yak5150/paddle-shift/CAD/pneumatics/tippmann-12oz-co2-paintball-tank-adapter-to-cga320-1.snapshot.4/Screenshot 2023-11-20 222517.png

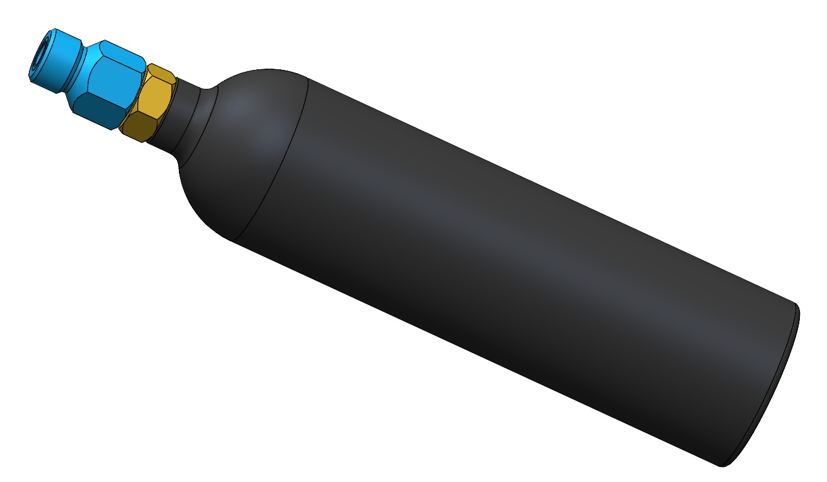
CAD/pneumatics/tippmann-12oz-co2-paintball-tank-adapter-to-cga320-1.snapshot.4/Screenshot 2023-11-20 222517.png
