yak5150/paddle-shift/classwork/SD2_Team17_advisor approval.png

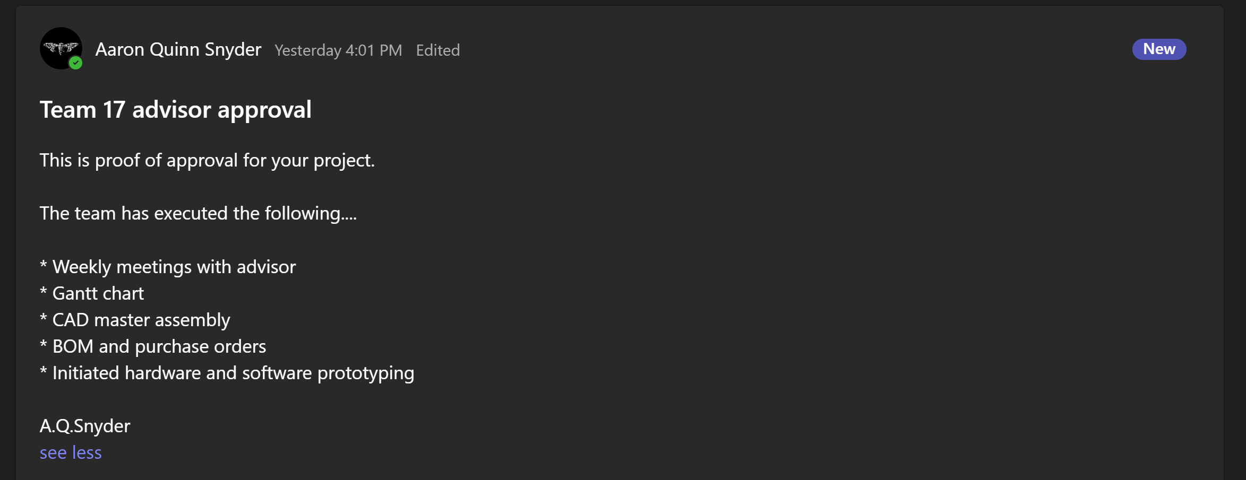
classwork/SD2_Team17_advisor approval.png
