yak5150/paddle-shift/budget/Order 2024-02-01.xlsx

Sheet: Master
SD II - 24SP - Team 17 |  | Order Date: [insert] |  |  |  | Est. Total | $224.59
Category | Description | Part No. | Link | Qty | Price | Est. Shipping | Total Cost | Notes | Team Signed | Advisor Signed | Order Date | Delivered Date | Mechanical
Mechanical | Arbitary 6061 Aluminum Billet |  | https://www.mcmaster.com/8975K253-8975K311/ | 1 | $37.56 |  | $37.56 |  |  |  |  |  | Electrical
Pneumatic | 4 way 3 postion solenoid valve | 4V130E-1/8 | https://www.stcvalve.com/Solenoid-Valve/4V130C-E-P-1-8.htm | 1 | $101.79 |  | $101.79 |  | yes | yes |  |  | Pneumatic
Pneumatic | CO2 tank |  | https://www.discountpaintball.com/tippmann-12oz-aluminum-co2-tank-for-paintball.html | 1 | $17.90 | $10.00 | $27.90 |  | yes | yes
Pneumatic | N2 tank | 48ci/3000psi | https://www.amazon.com/HK-Army-Aluminum-Compressed-Paintball/dp/B07MR6QCSR?th=1 | 1 | $49.95 | $0.00 | $49.95 | 48 ci 3000 psi, black | yes | yes
Pneumatic | fittings |  |  |  |  |  | $0.00
Electrical | Arduino |  |  | 1 | $0.00 | $0.00 | $0.00 | Free | yes | yes
Pneumatic | Air cylinder |  |  |  |  |  | $0.00
Pneumatic | Air regulator |  |  |  |  |  | $0.00
Pneumatic | Air lines |  |  |  |  |  | $0.00
Mechanical | Springs |  |  |  |  |  | $0.00
Mechanical | Bushings |  |  |  |  |  | $0.00
Mechanical | Hardware |  |  |  |  |  | $0.00
Electrical | Sensors |  |  |  |  |  | $0.00
Electrical | 12 VDC 4 Channel Relay Module (https://www.amazon.com/dp/B00LW2GM84?asc_source=01HFY6QA7Q8N1TT2Z879WGSZ46&tag=snx79-20) |  | Amazon.com: HiLetgo 12V 4 Channel Relay Module with OPTO-Isolated Support High and Low Level Trigger : Industrial & Scientific (https://www.amazon.com/dp/B00LW2GM84?asc_source=01HFY6QA7Q8N1TT2Z879WGSZ46&tag=snx79-20) | 1 | $7.39 |  | $7.39 | Lets wait to see which types of sensors we are going to use to determine if 4 relay modules is enough

Sheet: Order 2024-02-01
SD II - 24SP - Team 17 |  | Order Date: 2024-02-01 |  |  |  | Est. Total | $179.64
Category | Description | Part No. | Link | Qty | Price | Est. Shipping | Total Cost | Notes | Team Signed | Advisor Signed | Order Date | Delivered Date | Mechanical
Pneumatic | 4 way 3 postion solenoid valve | 4V130E-1/8 | https://www.stcvalve.com/Solenoid-Valve/4V130C-E-P-1-8.htm | 1 | $101.79 |  | $101.79 |  | yes | yes |  |  | Electrical
Pneumatic | CO2 tank | 100-640-01010 | https://www.discountpaintball.com/tippmann-12oz-aluminum-co2-tank-for-paintball.html | 1 | $17.90 | $10.00 | $27.90 |  | yes | yes |  |  | Pneumatic
Pneumatic | N2 tank | 48ci/3000psi | https://www.amazon.com/HK-Army-Aluminum-Compressed-Paintball/dp/B07MR6QCSR?th=1 | 1 | $49.95 | $0.00 | $49.95 | 48 ci 3000 psi, black | yes | yes
