yak5150/paddle-shift/budget/Order 2024-02-16 (AutoDir).xlsx

SD II - 24SP - Team 17 |  | Order Date: 2024-02-16 |  |  |  | Est. Total | $193.75
Category | Description | Part No. | Link | Qty | Price | Est. Shipping | Total Cost | Notes | Team Signed | Advisor Signed | Order Date | Delivered Date | Mechanical
Pneumatic | flow control valve | FVS516-18N | https://www.automationdirect.com/adc/shopping/catalog/pneumatic_components/special_purpose_pneumatic_fittings/flow_control_valves_-_speed_controllers/fvs516-18n | 2 | $21.00 |  | $42.00 | Automation Direct |  |  | 2024-02-16
Pneumatic | air regulator | PRU516 | https://www.automationdirect.com/adc/shopping/catalog/pneumatic_components/special_purpose_pneumatic_fittings/pressure_regulators_-z-_gauges_-z-_indicators/pr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 | 1 | $26.50 |  | $26.50 | Automation Direct |  |  | 2024-02-16
Pneumatic | on-off valve | HVU516-2 | https://www.automationdirect.com/adc/shopping/catalog/pneumatic_components/special_purpose_pneumatic_fittings/hand_valves/hvu516-2 | 1 | $15.50 |  | $15.50 | Automation Direct |  |  | 2024-02-16
Pneumatic | cylinder | A17010DP | https://www.automationdirect.com/adc/shopping/catalog/pneumatic_components/pneumatic_air_cylinders/non-repairable/a17010dp | 1 | $35.00 |  | $35.00 | Automation Direct |  |  | 2024-02-16
Pneumatic | exhaust silencer/filter | SBF-18N | https://www.automationdirect.com/adc/shopping/catalog/pneumatic_components/exhaust_silencers/bronze_exhaust_silencers/sbf-18n | 1 | $3.25 |  | $3.25 | Automation Direct |  |  | 2024-02-16
Pneumatic | air pressure gauge | PGU516 | https://www.automationdirect.com/adc/shopping/catalog/pneumatic_components/special_purpose_pneumatic_fittings/pressure_regulators_-z-_gauges_-z-_indicators/pg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 | 1 | $23.50 |  | $23.50 | Automation Direct |  |  | 2024-02-16
Pneumatic | 5/16" (8mm) air hose - 100ft roll | N8MRED100 | https://www.automationdirect.com/adc/shopping/catalog/pneumatic_components/flexible_pneumatic_tubing_-a-_hoses/straight_flexible_tubing/n8mred100 | 1 | $40.00 |  | $40.00 | Automation Direct |  |  | 2024-02-16
Pneumatic | male 1/8 NPT push to connect fitting | MS516-18N | https://www.automationdirect.com/adc/shopping/catalog/pneumatic_components/push-to-connect_pneumatic_fittings/male_straight_(hex_body)/ms516-18n | 1 | $8.00 |  | $8.00 | Automation Direct |  |  | 2024-02-16
