yak5150/paddle-shift/budget/Order 2024-03-11.xlsx

SD II - 24SP - Team 17 |  | Order Date: 2024-03-11 |  |  |  | Est. Total | $79.84
Category | Description | Part No. | Link | Qty | Price | Est. Shipping | Total Cost | Notes | Team Signed | Advisor Signed | Order Date | Delivered Date | Mechanical
Mechanical | Tight-Tolerance Low-Carbon Steel Rod | 6103N8 | https://www.mcmaster.com/6103N8-6103N81/ | 1 | $8.67 |  | $8.67 | Replacement part for 6061K31 | yes | yes | 2024-03-06
Mechanical | Single 4-Slot Rail, Silver, 1.5" High x 1.5" Wide, Hollow | 47065T102 | https://www.mcmaster.com/catalog/130/2230/47065T102 | 1 | $60.49 |  | $60.49 |  | yes | yes | 2024-03-06
Mechanical | End-Feed Single Nut with Button Head 5/16"-18 Thread | 47065T215 | https://www.mcmaster.com/47065T215/ | 3 | $3.56 |  | $10.68 |  | yes | yes | 2024-03-06
