yak5150/paddle-shift/budget/Order 2024-03-27.xlsx

SD II - 24SP - Team 17 |  | Order Date: [2024-03-27] |  |  |  | Est. Total | $70.99
Category | Description | Part No. | Link | Qty | Price | Est. Shipping | Total Cost | Notes | Team Signed | Advisor Signed | Order Date | Delivered Date | Mechanical
Pneumatic | male 1/8 NPT push to connect fitting | MS516-18N | https://www.automationdirect.com/adc/shopping/catalog/pneumatic_components/push-to-connect_pneumatic_fittings/male_straight_(hex_body)/ms516-18n | 1 | $8.00 |  | $8.00 |  | yes | yes | 2024-03-27
Pneumatic | Paintball Co2 Regulator Pressure Regulator for Airsoft HPA Tank Mini Sef Super Fast Refresh, Input 1500psi Output 0 to 130psi |  | https://www.amazon.com/AUGREX-Paintball-Regulator-Pressure-Airsoft/dp/B0BYN8LMY6 | 1 | $62.99 |  | $62.99 |  | yes |  | 2024-03-27
