yak5150/paddle-shift/budget/Team17_Parts24_Sp24.xlsx

Sheet: Master
SD II - 24SP - Team 17 |  | Order Date: [insert] |  |  |  | Est. Total | $362.58
Category | Description | Part No. | Link | Qty | Price | Est. Shipping | Total Cost | Notes | Team Signed | Advisor Signed | Order Date | Delivered Date | Mechanical
Pneumatic | 4 way 3 postion solenoid valve | 4V130E-1/8-12VDC | https://www.stcvalve.com/Solenoid-Valve/4V130C-E-P-1-8.htm | 1 | $101.79 |  | $101.79 | Select 12VDC when filling out order sheet. | yes | yes | 2024-02-01 | 2024-02-09 | Electrical
Pneumatic | CO2 tank | 12T-R | https://www.amazon.com/Tippmann-12T-R-12-Ounce-Co2-Tank/dp/B002DPLGH6 | 1 | $29.95 |  | $29.95 |  | yes | yes | 2024-02-01 | 2024-02-12 | Pneumatic
Pneumatic | N2 tank | 48ci/3000psi | https://www.amazon.com/HK-Army-Aluminum-Compressed-Paintball/dp/B07MR6QCSR?th=1 | 1 | $49.95 | $0.00 | $49.95 | 48 ci 3000 psi, black | yes | yes | 2024-02-01 | 2024-02-07
Mechanical | Springs 3x pack 1.75L x 0.75OD | 9657K96 | https://www.mcmaster.com/9657K96/ | 1 | $14.38 |  | $14.38 |  | yes |  | 2024-02-12
Mechanical | linear motion shaft 12"L x 0.25OD | 6061K31 | https://www.mcmaster.com/6061K31/ | 1 | $7.50 |  | $7.50 |  | yes |  | 2024-02-12
Mechanical | oil embedded flange bushings | 6338K413 | https://www.mcmaster.com/6338K413/ | 2 | $2.00 |  | $4.00 |  | yes |  | 2024-02-12
Electrical | Pressure Sensor |  | M12 X 1.5 Coolant Pressure & Temperature Combo 100 PSI / 500*F PN: 899 (lowdoller-motorsports.com) (https://lowdoller-motorsports.com/products/m12-x-1-5-coolant-pressure-temperature-combo-100-psi-500-f) | 1 | $90.00 |  | $90.00 |  |  |  | 2024-02-12 | 2024-02-15
Electrical | 12 VDC 4 Channel Relay Module (https://www.amazon.com/dp/B00LW2GM84?asc_source=01HFY6QA7Q8N1TT2Z879WGSZ46&tag=snx79-20) |  | Amazon.com: HiLetgo 12V 4 Channel Relay Module with OPTO-Isolated Support High and Low Level Trigger : Industrial & Scientific (https://www.amazon.com/dp/B00LW2GM84?asc_source=01HFY6QA7Q8N1TT2Z879WGSZ46&tag=snx79-20) | 1 | $7.39 |  | $7.39 |  | yes |  | 2024-02-12
Pneumatic | CO2 Refilling adaptor |  | Amazon.com : VaVoger Paintball CO2 Tank Refill Station CO2 Cartridges Fill Adapter Strage Stainless Steel Connector Hose for 12oz, 16oz, 20oz, CO2 Tanks : Sports & Outdoors (https://www.amazon.com/dp/B08MLG7S71?s=sporting-goods&sp_csd=d2lkZ2V0TmFtZT1zcF9kZXRhaWxfdGhlbWF0aWM) | 1 | $38.99 | $0.00 |  |  | yes |  | 2024-02-12
Pneumatic | CO2 Scale |  | Amazon.com : HEETA Fish Scale with Backlit LCD Display, Up to 110lb/50kg Digital Portable Hanging Fish Weight Scale with Hook & Measuring Tape for Home, Farm, Outdoor, Hunting, Fishing, 2 AAA Batteries Included : Sports & Outdoors (https://www.amazon.com/HEETA-Portable-Measuring-Batteries-Included/dp/B07SSYVWTJ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) | 1 | $9.99 | $0.00 | $9.99 |  | yes |  | 2024-02-12
Electrical | 12 V to 5 V Buck Converter |  | https://www.amazon.com/Converter-DROK-Regulator-Inverter-Transformer/dp/B01NALDSJ0 | 1 | $9.99 | $0.00 | $9.99 | To power sensors | yes |  | 2024-02-12
Electrical | Arduino |  |  | 1 | $0.00 | $0.00 | $0.00 | Free | yes | yes |  | 2024-01-31
Pneumatic | Nitrogen Tank Refill Fitting
Electrical | MAX31865 Temperature Sensor Amplifier |  | https://www.digikey.com/en/products/detail/adafruit-industries-llc/3328/6562952 | 2 | $15.00 |  | $30.00 | To convert temperature sensor into readable values for Arduino | yes | yes | 2024-02-19
Pneumatic | flow control valve | FVS516-18N | https://www.automationdirect.com/adc/shopping/catalog/pneumatic_components/special_purpose_pneumatic_fittings/flow_control_valves_-_speed_controllers/fvs516-18n | 2 | $0.00 |  | $0.00 | Automation Direct - Free | yes | yes | 2024-02-16
Pneumatic | air regulator | PRU516 | https://www.automationdirect.com/adc/shopping/catalog/pneumatic_components/special_purpose_pneumatic_fittings/pressure_regulators_-z-_gauges_-z-_indicators/pr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 | 1 | $0.00 |  | $0.00 | Automation Direct - Free | yes | yes | 2024-02-16
Pneumatic | on-off valve | HVU516-2 | https://www.automationdirect.com/adc/shopping/catalog/pneumatic_components/special_purpose_pneumatic_fittings/hand_valves/hvu516-2 | 1 | $0.00 |  | $0.00 | Automation Direct - Free | yes | yes | 2024-02-16
Pneumatic | cylinder | A17010DP | https://www.automationdirect.com/adc/shopping/catalog/pneumatic_components/pneumatic_air_cylinders/non-repairable/a17010dp | 1 | $0.00 |  | $0.00 | Automation Direct - Free | yes | yes | 2024-02-16
Pneumatic | exhaust silencer/filter | SBF-18N | https://www.automationdirect.com/adc/shopping/catalog/pneumatic_components/exhaust_silencers/bronze_exhaust_silencers/sbf-18n | 1 | $0.00 |  | $0.00 | Automation Direct - Free | yes | yes | 2024-02-16
Pneumatic | air pressure gauge | PGU516 | https://www.automationdirect.com/adc/shopping/catalog/pneumatic_components/special_purpose_pneumatic_fittings/pressure_regulators_-z-_gauges_-z-_indicators/pg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 | 1 | $0.00 |  | $0.00 | Automation Direct - Free | yes | yes | 2024-02-16
Pneumatic | 5/16" (8mm) air hose - 100ft roll | N8MRED100 | https://www.automationdirect.com/adc/shopping/catalog/pneumatic_components/flexible_pneumatic_tubing_-a-_hoses/straight_flexible_tubing/n8mred100 | 1 | $0.00 |  | $0.00 | Automation Direct - Free | yes | yes | 2024-02-16
Pneumatic | male 1/8 NPT push to connect fitting | MS516-18N | https://www.automationdirect.com/adc/shopping/catalog/pneumatic_components/push-to-connect_pneumatic_fittings/male_straight_(hex_body)/ms516-18n | 1 | $0.00 |  | $0.00 | Automation Direct - Free | yes | yes | 2024-02-16
Mechanical | 1.5 X 1.5 60"Long Lite, Clear Anodise 8020 |  | 8020, 1515, 15 Series 1.5 Inch x 1.5 Inch T-Slotted Aluminum Extrusion DIY Extruded Linear Slot Bar Rail 80/20 (Ultra Light Smooth, Clear Anodize, 60" Long): Shelving Hardware: Amazon.com: Industrial & Scientific (https://www.amazon.com/80-20-1515-ULS-T-Slotted-Extrusion/dp/B07TGKRD2W) | 1 | $41.19
z | 8020 harware M5 x0.8 |  | Amazon.com: Black Screws Nuts Kit for 2020 2028 Series Conrner Bracket Connector, 40Pcs M5 x 10mm, M5 x 8mm Hex Socket Button Head Cap Screws Bolts, 40PCS M5 Slide in T Nut, M5 Drop in T Nut, 40PCS M5 Washers : Industrial & Scientific (https://www.amazon.com/Screws-Conrner-Bracket-Connector-Washers/dp/B08VGSNT2S?s=hi) | 1 | $13.88
Mechanical | M5 x 0.8 mm screw (25 mm length) | 92095A216 | Button Head Hex Drive Screw, Passivated 18-8 Stainless Steel, M5 x 0.80 mm Thread, 25mm Long | McMaster-Carr (https://www.mcmaster.com/92095A216/) | 1 | $7.64 |  | $7.64

Sheet: Order 2024-02-26
Mechanical | 1.5 X 1.5 60"Long Lite, Clear Anodise 8020 |  | 8020, 1515, 15 Series 1.5 Inch x 1.5 Inch T-Slotted Aluminum Extrusion DIY Extruded Linear Slot Bar Rail 80/20 (Ultra Light Smooth, Clear Anodize, 60" Long): Shelving Hardware: Amazon.com: Industrial & Scientific (https://www.amazon.com/80-20-1515-ULS-T-Slotted-Extrusion/dp/B07TGKRD2W) | 1 | $41.19
Mechanical | 8020 harware M5 x0.8 |  | Amazon.com: Black Screws Nuts Kit for 2020 2028 Series Conrner Bracket Connector, 40Pcs M5 x 10mm, M5 x 8mm Hex Socket Button Head Cap Screws Bolts, 40PCS M5 Slide in T Nut, M5 Drop in T Nut, 40PCS M5 Washers : Industrial & Scientific (https://www.amazon.com/Screws-Conrner-Bracket-Connector-Washers/dp/B08VGSNT2S?s=hi) | 1 | $13.88
Mechanical | M5 x 0.8 mm screw (25 mm length) | 92095A216 | Button Head Hex Drive Screw, Passivated 18-8 Stainless Steel, M5 x 0.80 mm Thread, 25mm Long | McMaster-Carr (https://www.mcmaster.com/92095A216/) | 1 | $7.64 | $29.95

Sheet: Order 2024-02-01
SD II - 24SP - Team 17 |  | Order Date: [2024-02-01] |  |  |  | Est. Total | $181.69
Category | Description | Part No. | Link | Qty | Price | Est. Shipping | Total Cost | Notes | Team Signed | Advisor Signed | Order Date | Delivered Date | Mechanical
Pneumatic | 4 way 3 postion solenoid valve | 4V130E-1/8-12VDC | https://www.stcvalve.com/Solenoid-Valve/4V130C-E-P-1-8.htm | 1 | $101.79 |  | $101.79 | Select 12VDC when filling out order sheet. | yes | yes | 2024-02-01 |  | Electrical
Pneumatic | CO2 tank | 12T-R | https://www.amazon.com/Tippmann-12T-R-12-Ounce-Co2-Tank/dp/B002DPLGH6 | 1 | $29.95 |  | $29.95 |  | yes | yes | 2024-02-01 |  | Pneumatic
Pneumatic | N2 tank | 48ci/3000psi | https://www.amazon.com/HK-Army-Aluminum-Compressed-Paintball/dp/B07MR6QCSR?th=1 | 1 | $49.95 | $0.00 | $49.95 | 48 ci 3000 psi, black | yes | yes | 2024-02-01

Sheet: Order 2024-02-12
SD II - 24SP - Team 17 |  | Order Date: [2024-02-12] |  |  |  | Est. Total | $272.24
Category | Description | Part No. | Link | Qty | Price | Est. Shipping | Total Cost | Notes | Team Signed | Advisor Signed | Order Date | Delivered Date
Electrical | Pressure Sensor |  | M12 X 1.5 Coolant Pressure & Temperature Combo 100 PSI / 500*F PN: 899 (lowdoller-motorsports.com) (https://lowdoller-motorsports.com/products/m12-x-1-5-coolant-pressure-temperature-combo-100-psi-500-f) | 2 | $90.00 |  | $180.00 |  |  |  | 2024-02-12
Electrical | 12 VDC 4 Channel Relay Module (https://www.amazon.com/dp/B00LW2GM84?asc_source=01HFY6QA7Q8N1TT2Z879WGSZ46&tag=snx79-20) |  | Amazon.com: HiLetgo 12V 4 Channel Relay Module with OPTO-Isolated Support High and Low Level Trigger : Industrial & Scientific (https://www.amazon.com/dp/B00LW2GM84?asc_source=01HFY6QA7Q8N1TT2Z879WGSZ46&tag=snx79-20) | 1 | $7.39 |  | $7.39 |  |  |  | 2024-02-12
Pneumatic | CO2 Refilling adaptor |  | Amazon.com : VaVoger Paintball CO2 Tank Refill Station CO2 Cartridges Fill Adapter Strage Stainless Steel Connector Hose for 12oz, 16oz, 20oz, CO2 Tanks : Sports & Outdoors (https://www.amazon.com/dp/B08MLG7S71?s=sporting-goods&sp_csd=d2lkZ2V0TmFtZT1zcF9kZXRhaWxfdGhlbWF0aWM) | 1 | $38.99 | $0.00 | $38.99 |  |  |  | 2024-02-12
Pneumatic | CO2 Scale |  | Amazon.com : HEETA Fish Scale with Backlit LCD Display, Up to 110lb/50kg Digital Portable Hanging Fish Weight Scale with Hook & Measuring Tape for Home, Farm, Outdoor, Hunting, Fishing, 2 AAA Batteries Included : Sports & Outdoors (https://www.amazon.com/HEETA-Portable-Measuring-Batteries-Included/dp/B07SSYVWTJ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) | 1 | $9.99 | $0.00 | $9.99 |  |  |  | 2024-02-12
Electrical | 12 V to 5 V Buck Converter |  | https://www.amazon.com/Converter-DROK-Regulator-Inverter-Transformer/dp/B01NALDSJ0 | 1 | $9.99 | $0.00 | $9.99 | To power sensors |  |  | 2024-02-12
Mechanical | Springs 3x pack 1.75L x 0.75OD | 9657K96 | https://www.mcmaster.com/9657K96/ | 1 | $14.38 |  | $14.38 |  | yes |  | 2024-02-12
Mechanical | linear motion shaft 12"L x 0.25OD | 6061K31 | https://www.mcmaster.com/6061K31/ | 1 | $7.50 |  | $7.50 |  | yes |  | 2024-02-12
Mechanical | oil embedded flange bushings | 6338K413 | https://www.mcmaster.com/6338K413/ | 2 | $2.00 |  | $4.00 |  | yes |  | 2024-02-12

Sheet: Order 2024-02-16 (AutoDir)
SD II - 24SP - Team 17 |  | Order Date: 2024-02-16 |  |  |  | Est. Total | $193.75
Category | Description | Part No. | Link | Qty | Price | Est. Shipping | Total Cost | Notes | Team Signed | Advisor Signed | Order Date | Delivered Date | Mechanical
Pneumatic | flow control valve | FVS516-18N | https://www.automationdirect.com/adc/shopping/catalog/pneumatic_components/special_purpose_pneumatic_fittings/flow_control_valves_-_speed_controllers/fvs516-18n | 2 | $21.00 |  | $42.00 | Automation Direct |  |  | 2024-02-16
Pneumatic | air regulator | PRU516 | https://www.automationdirect.com/adc/shopping/catalog/pneumatic_components/special_purpose_pneumatic_fittings/pressure_regulators_-z-_gauges_-z-_indicators/pr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 | 1 | $26.50 |  | $26.50 | Automation Direct |  |  | 2024-02-16
Pneumatic | on-off valve | HVU516-2 | https://www.automationdirect.com/adc/shopping/catalog/pneumatic_components/special_purpose_pneumatic_fittings/hand_valves/hvu516-2 | 1 | $15.50 |  | $15.50 | Automation Direct |  |  | 2024-02-16
Pneumatic | cylinder | A17010DP | https://www.automationdirect.com/adc/shopping/catalog/pneumatic_components/pneumatic_air_cylinders/non-repairable/a17010dp | 1 | $35.00 |  | $35.00 | Automation Direct |  |  | 2024-02-16
Pneumatic | exhaust silencer/filter | SBF-18N | https://www.automationdirect.com/adc/shopping/catalog/pneumatic_components/exhaust_silencers/bronze_exhaust_silencers/sbf-18n | 1 | $3.25 |  | $3.25 | Automation Direct |  |  | 2024-02-16
Pneumatic | air pressure gauge | PGU516 | https://www.automationdirect.com/adc/shopping/catalog/pneumatic_components/special_purpose_pneumatic_fittings/pressure_regulators_-z-_gauges_-z-_indicators/pg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 | 1 | $23.50 |  | $23.50 | Automation Direct |  |  | 2024-02-16
Pneumatic | 5/16" (8mm) air hose - 100ft roll | N8MRED100 | https://www.automationdirect.com/adc/shopping/catalog/pneumatic_components/flexible_pneumatic_tubing_-a-_hoses/straight_flexible_tubing/n8mred100 | 1 | $40.00 |  | $40.00 | Automation Direct |  |  | 2024-02-16
Pneumatic | male 1/8 NPT push to connect fitting | MS516-18N | https://www.automationdirect.com/adc/shopping/catalog/pneumatic_components/push-to-connect_pneumatic_fittings/male_straight_(hex_body)/ms516-18n | 1 | $8.00 |  | $8.00 | Automation Direct |  |  | 2024-02-16
