yak5150/paddle-shift/classwork/Template_Budget_Fa23.xlsx

Team XXX
 | Item | Supplier | Part Number | URL (if appropriate) | Unit Cost | Number | Est Shipping | Total Cost
SUPPLIES | widget | Acme supplies | XX00123 | www.roadrunner.com | $1.98 | 3 |  | $5.94
 |  |  |  |  |  | FINAL COST |  | $0.00
