yak5150/paddle-shift/CAD/test_bench_assy.SLDASM

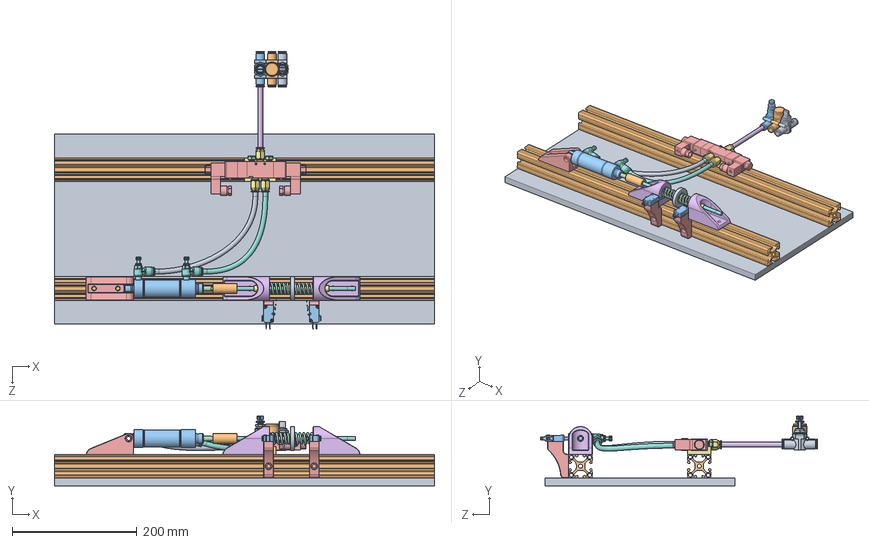
[picture p19: CAD file, 2024-04-10]
CAD/test_bench_assy.SLDASM
609.6 x 112.1 x 444.6 mm
bench
47065T144_T-Slotted Framing x 2
a17010dp_01
a17010dp_02
cylinder support
shaft support x 2
6338K413_Oil-Embedded Flanged Sleeve Bearing x 2
6061K31_Linear Motion Shaft x 2
spring pusher
coupler
7779K23_Miniature Snap-Acting Switch x 2
9657K96_Compression Spring x 2
switch mount x 2
90850A100_Grade 9 Steel Washer x 2
ms516-18n x 3
fvs516-18n x 2
hvu516-2
pgu516
pru516
sbf-18n x 2
4V130(CEP)-06-D
line-reg-sol
solenoid mount
line-cyl-retract
line-cyl-extend
