yak5150/paddle-shift/CAD/pneumatics/tippmann-12oz-co2-paintball-tank-adapter-to-cga320-1.snapshot.4/Bottle w adapter ASSY.SLDASM

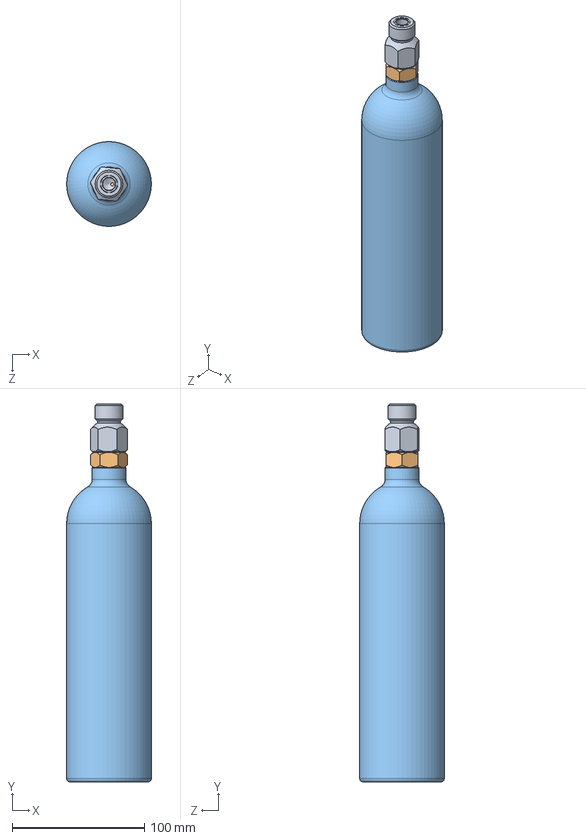
[picture p20: CAD file, 2024-04-10]
CAD/pneumatics/tippmann-12oz-co2-paintball-tank-adapter-to-cga320-1.snapshot.4/Bottle w adapter ASSY.SLDASM
64.1 x 286.0 x 64.0 mm
Bottle
Bottle Top
Paintball x CGA320 Adapter
