yak5150/paddle-shift/CAD/actuator_mech/actuator_mech_assy.SLDASM

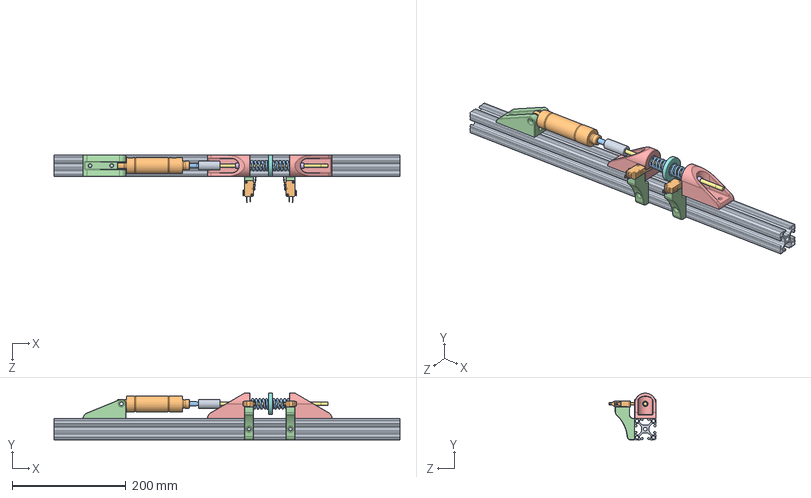
[picture p21: CAD file, 2024-04-10]
CAD/actuator_mech/actuator_mech_assy.SLDASM
609.6 x 82.5 x 83.4 mm
47065T144_T-Slotted Framing
a17010dp_01
a17010dp_02
cylinder support
shaft support x 2
6338K413_Oil-Embedded Flanged Sleeve Bearing x 2
6061K31_Linear Motion Shaft x 2
spring pusher
coupler
7779K23_Miniature Snap-Acting Switch x 2
9657K96_Compression Spring x 2
switch mount x 2
90850A100_Grade 9 Steel Washer x 2
