yak5150/paddle-shift/CAD/pneumatics/pneumatics_assy.SLDASM

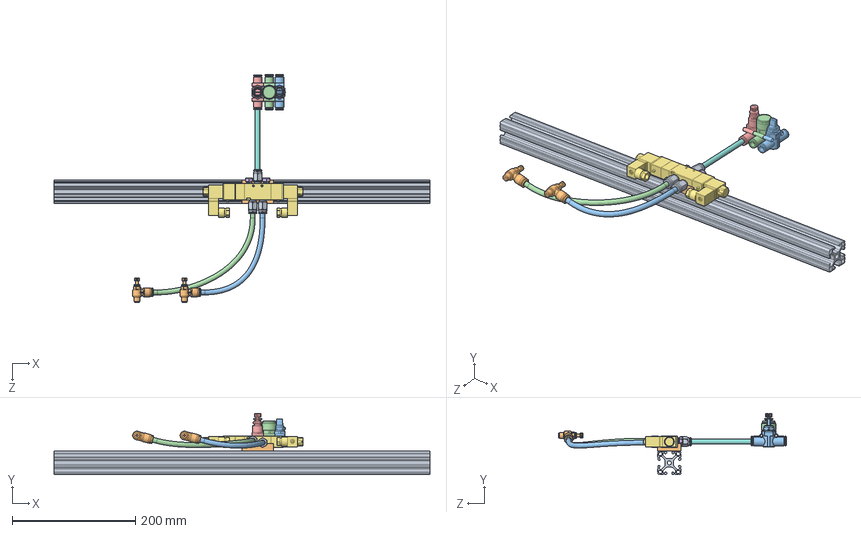
[picture p22: CAD file, 2024-04-10]
CAD/pneumatics/pneumatics_assy.SLDASM
609.6 x 99.4 x 369.2 mm
ms516-18n x 3
fvs516-18n x 2
hvu516-2
pgu516
pru516
sbf-18n x 2
4V130(CEP)-06-D
line-reg-sol
47065T144_T-Slotted Framing
solenoid mount
line-cyl-retract
line-cyl-extend
