yak5150/paddle-shift/CAD/actuator_mech/print 2024-02-12/shaft support.STL

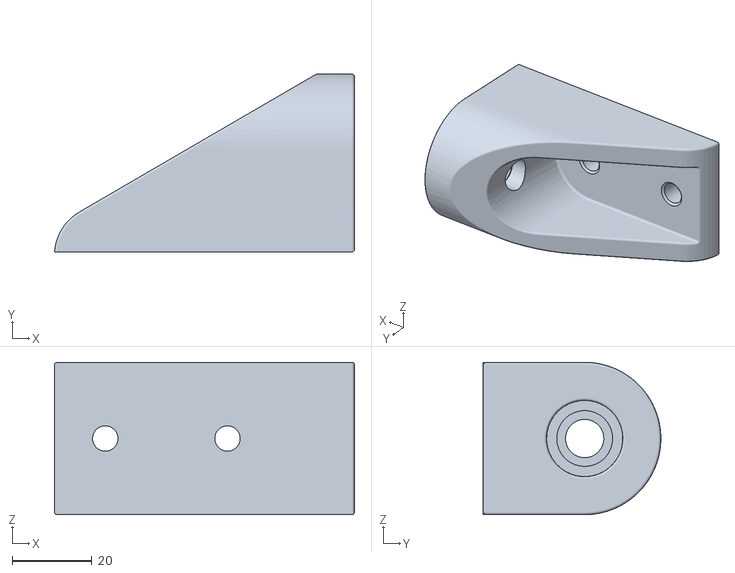
[picture p23: CAD file, 2024-04-10]
CAD/actuator_mech/print 2024-02-12/shaft support.STL
75.0 x 44.4 x 38.1
