yak5150/paddle-shift/CAD/actuator_mech/print 2024-02-21/switch mount (right).STL

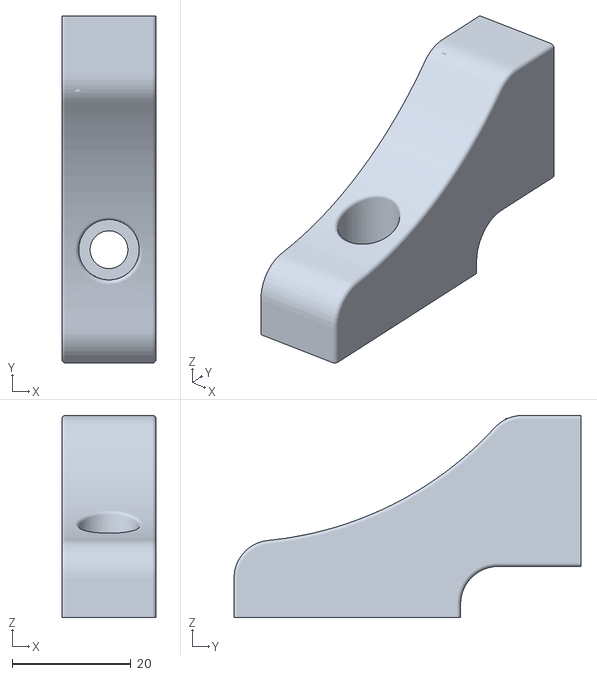
[picture p24: CAD file, 2024-04-10]
CAD/actuator_mech/print 2024-02-21/switch mount (right).STL
15.9 x 58.4 x 34.0
