yak5150/paddle-shift/CAD/pneumatics/pru516.SLDPRT

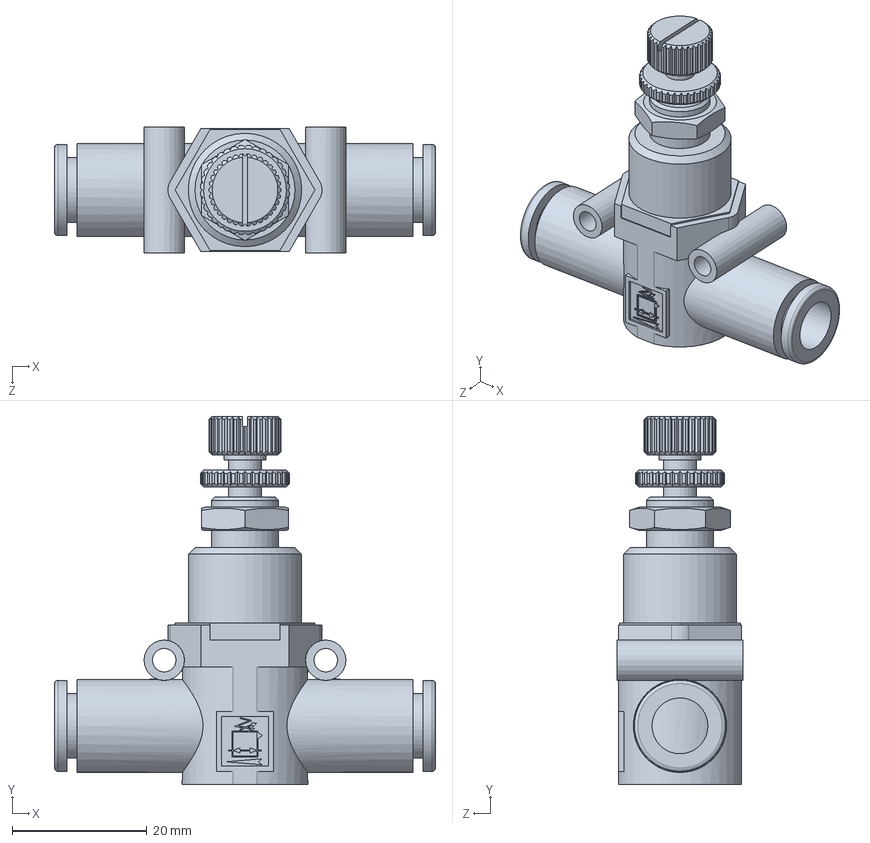
[picture p25: CAD file, 2024-04-10]
CAD/pneumatics/pru516.SLDPRT
56.6 x 54.8 x 18.7 mm
