yak5150/paddle-shift/CAD/pneumatics/tippmann-12oz-co2-paintball-tank-adapter-to-cga320-1.snapshot.4/Bottle Top.SLDPRT

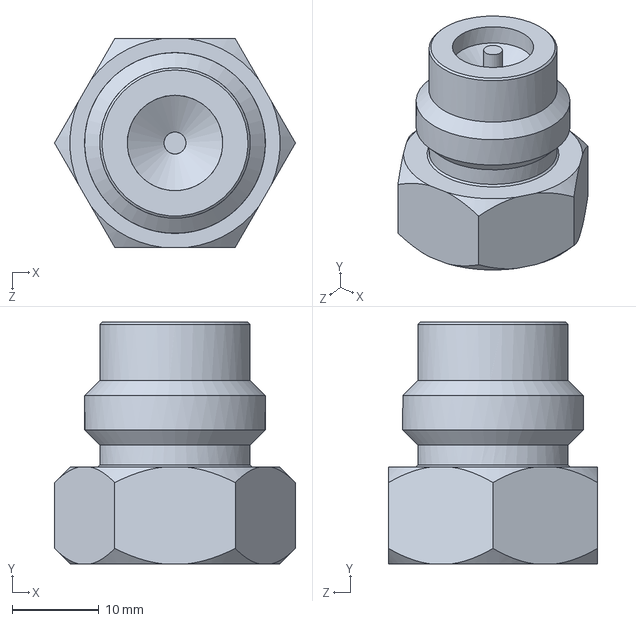
[picture p26: CAD file, 2024-04-10]
CAD/pneumatics/tippmann-12oz-co2-paintball-tank-adapter-to-cga320-1.snapshot.4/Bottle Top.SLDPRT
27.9 x 27.9 x 24.1 mm
