yak5150/paddle-shift/CAD/actuator_mech/print 2024-02-21/cylinder support.STL

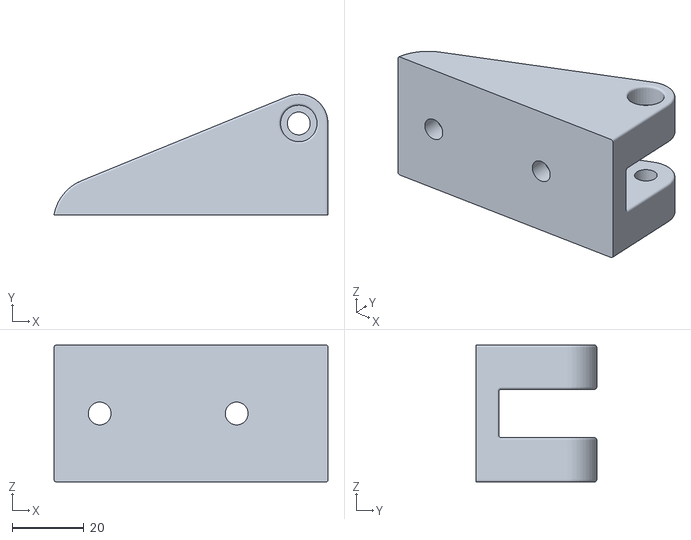
[picture p27: CAD file, 2024-04-10]
CAD/actuator_mech/print 2024-02-21/cylinder support.STL
76.2 x 33.5 x 38.1
