yak5150/paddle-shift/CAD/bench.SLDPRT

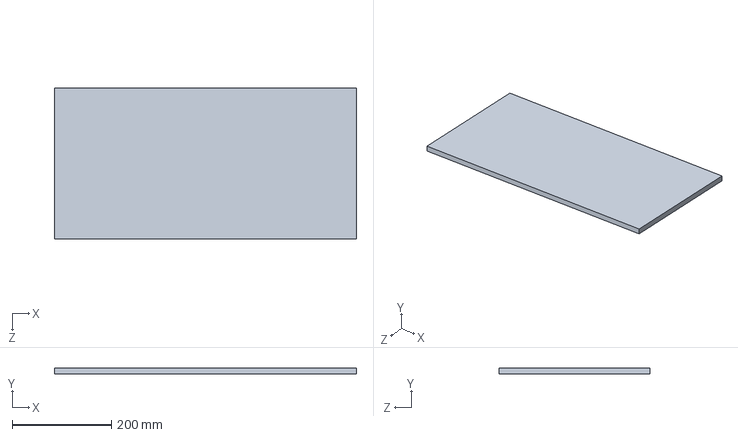
[picture p28: CAD file, 2024-04-10]
CAD/bench.SLDPRT
609.6 x 12.7 x 304.8 mm
