yak5150/paddle-shift/CAD/pneumatics/solenoid mount.SLDPRT

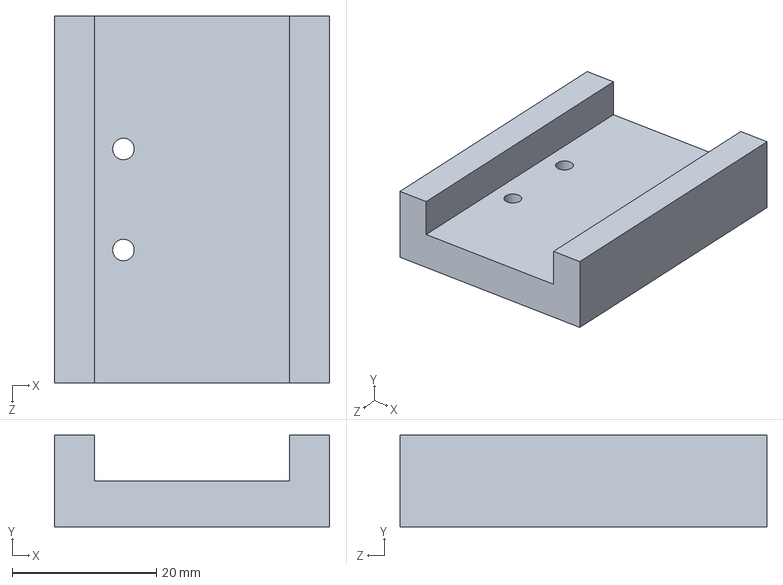
[picture p29: CAD file, 2024-04-10]
CAD/pneumatics/solenoid mount.SLDPRT
38.1 x 12.7 x 50.8 mm
