yak5150/paddle-shift/CAD/actuator_mech/coupler.SLDPRT

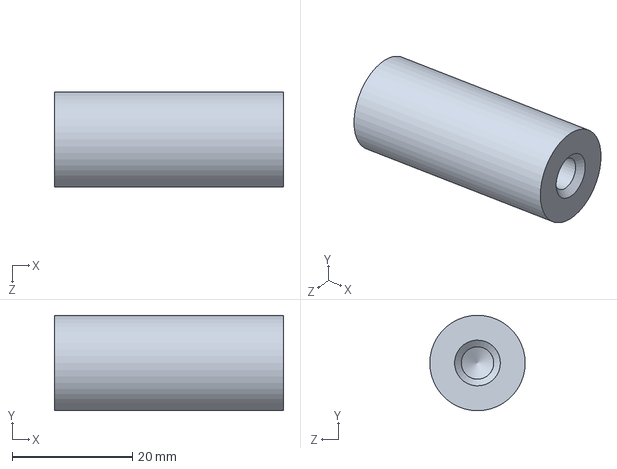
[picture p30: CAD file, 2024-04-10]
CAD/actuator_mech/coupler.SLDPRT
38.1 x 15.9 x 15.9 mm
