yak5150/paddle-shift/CAD/pneumatics/line-reg-sol.SLDPRT

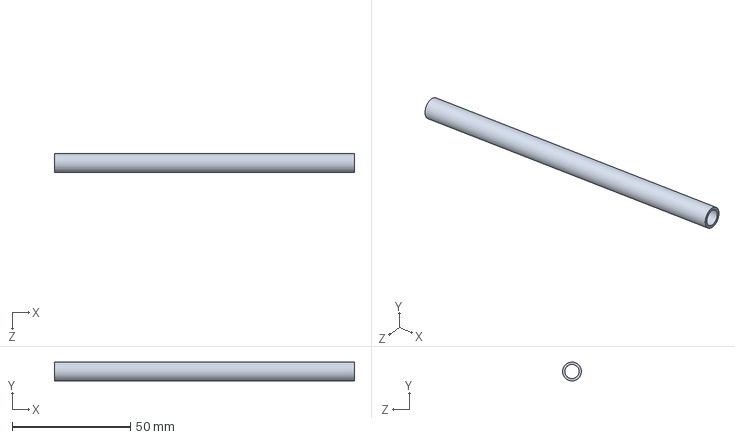
[picture p31: CAD file, 2024-04-10]
CAD/pneumatics/line-reg-sol.SLDPRT
127.0 x 7.99 x 7.98 mm
