yak5150/paddle-shift/CAD/pneumatics/tippmann-12oz-co2-paintball-tank-adapter-to-cga320-1.snapshot.4/Paintball x CGA320 Adapter.SLDPRT

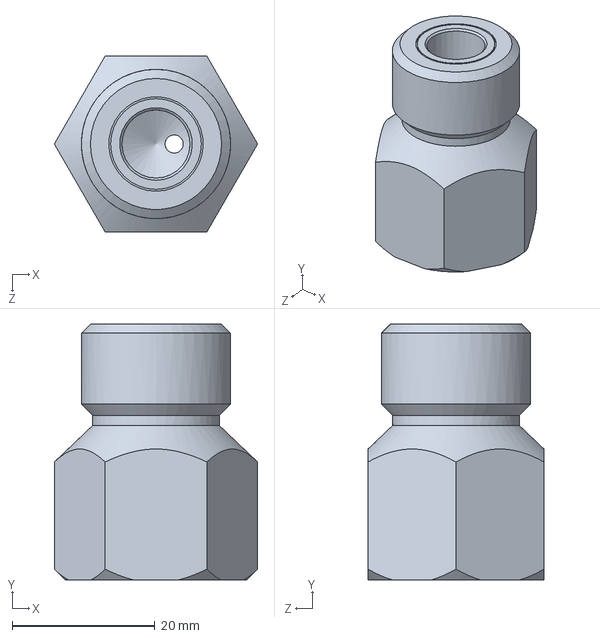
[picture p32: CAD file, 2024-04-10]
CAD/pneumatics/tippmann-12oz-co2-paintball-tank-adapter-to-cga320-1.snapshot.4/Paintball x CGA320 Adapter.SLDPRT
28.4 x 35.8 x 24.6 mm
