yak5150/paddle-shift/CAD/actuator_mech/spring pusher.SLDPRT

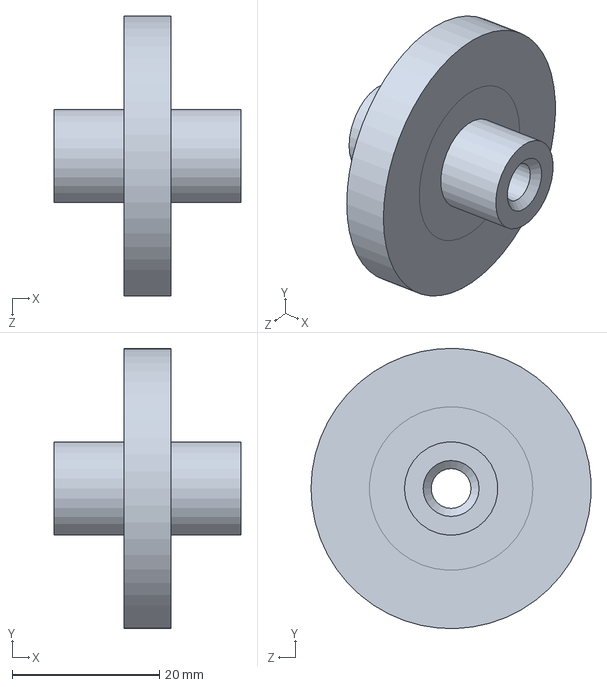
[picture p33: CAD file, 2024-04-10]
CAD/actuator_mech/spring pusher.SLDPRT
25.4 x 38.1 x 38.1 mm
