yak5150/paddle-shift/CAD/pneumatics/hvu516-2.SLDPRT

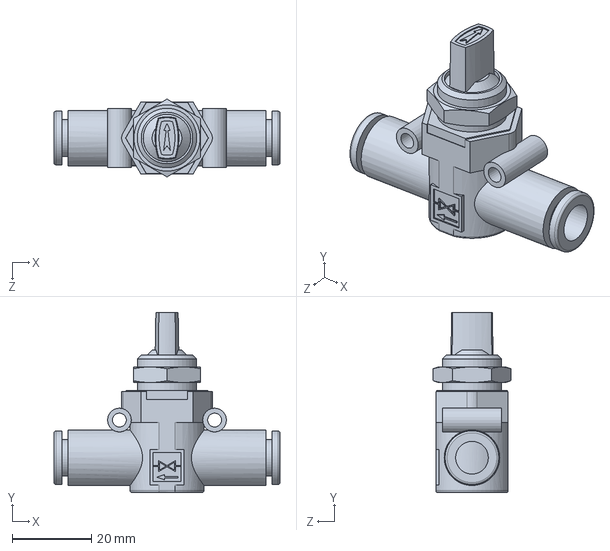
[picture p34: CAD file, 2024-04-10]
CAD/pneumatics/hvu516-2.SLDPRT
57.0 x 45.5 x 19.6 mm
