yak5150/paddle-shift/CAD/pneumatics/tippmann-12oz-co2-paintball-tank-adapter-to-cga320-1.snapshot.4/Bottle.SLDPRT

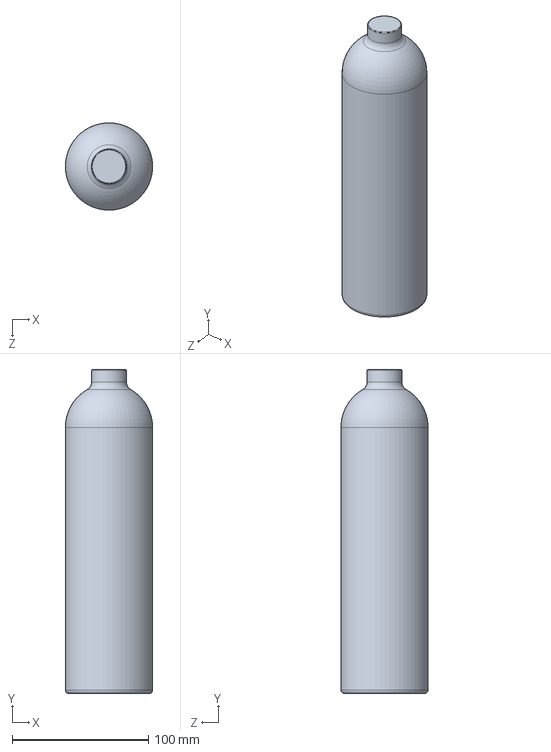
[picture p35: CAD file, 2024-04-10]
CAD/pneumatics/tippmann-12oz-co2-paintball-tank-adapter-to-cga320-1.snapshot.4/Bottle.SLDPRT
64.1 x 238.1 x 64.0 mm
