yak5150/paddle-shift/CAD/pneumatics/pgu516.SLDPRT

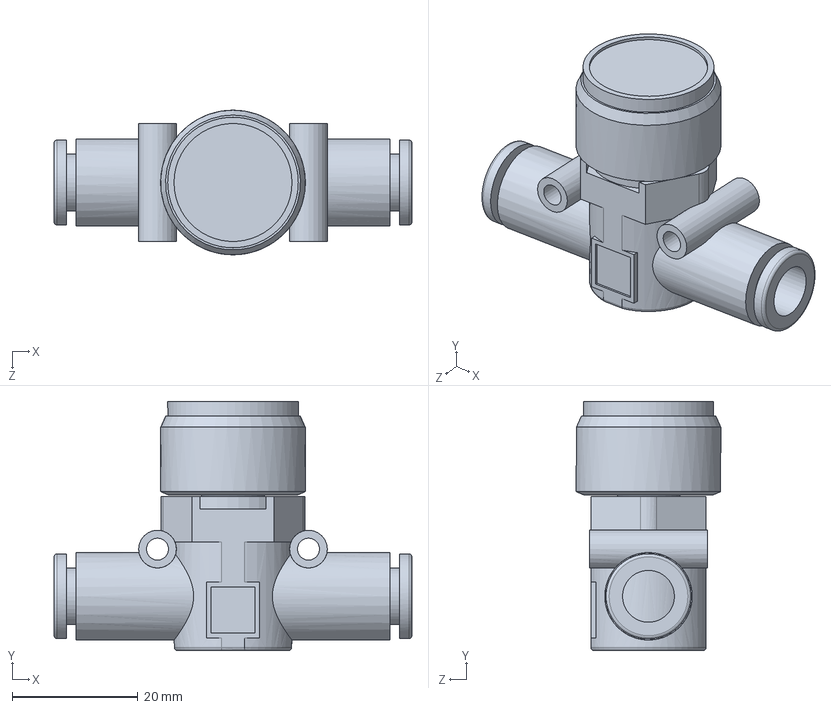
[picture p36: CAD file, 2024-04-10]
CAD/pneumatics/pgu516.SLDPRT
56.9 x 39.6 x 23.0 mm
