yak5150/paddle-shift/CAD/pneumatics/4V130(CEP)-06-D.SLDPRT

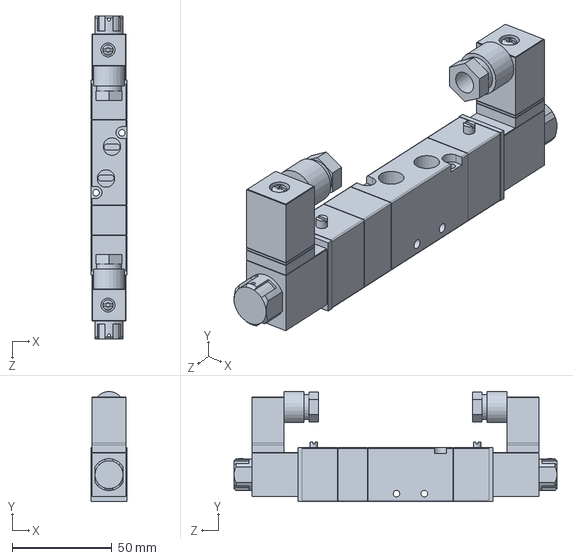
[picture p37: CAD file, 2024-04-10]
CAD/pneumatics/4V130(CEP)-06-D.SLDPRT
18.0 x 55.2 x 162.0 mm
