yak5150/paddle-shift/CAD/pneumatics/fvs516-18n.SLDPRT

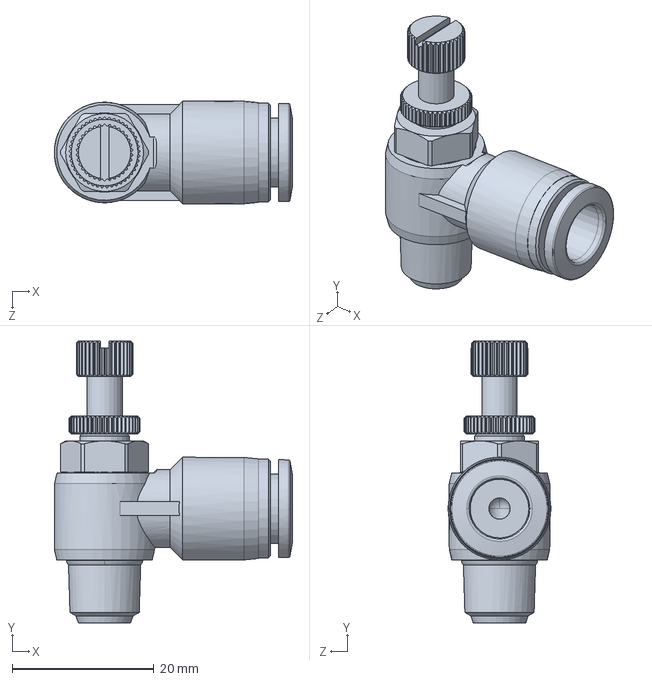
[picture p38: CAD file, 2024-04-10]
CAD/pneumatics/fvs516-18n.SLDPRT
33.6 x 39.8 x 14.5 mm
