yak5150/paddle-shift/CAD/pneumatics/line-cyl-extend.SLDPRT

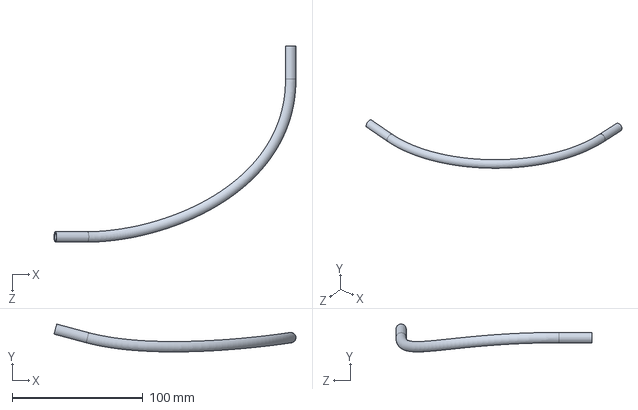
[picture p39: CAD file, 2024-04-10]
CAD/pneumatics/line-cyl-extend.SLDPRT
185.0 x 21.3 x 150.1 mm
