yak5150/paddle-shift/CAD/pneumatics/ms516-18n.SLDPRT

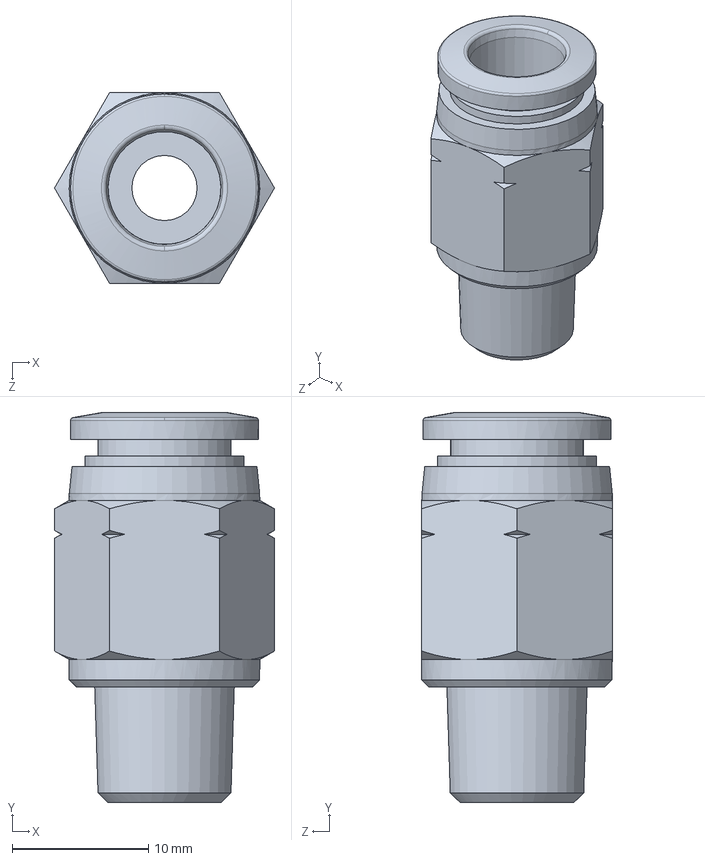
[picture p40: CAD file, 2024-04-10]
CAD/pneumatics/ms516-18n.SLDPRT
16.2 x 28.6 x 14.0 mm
