yak5150/paddle-shift/CAD/pneumatics/sbf-18n.SLDPRT

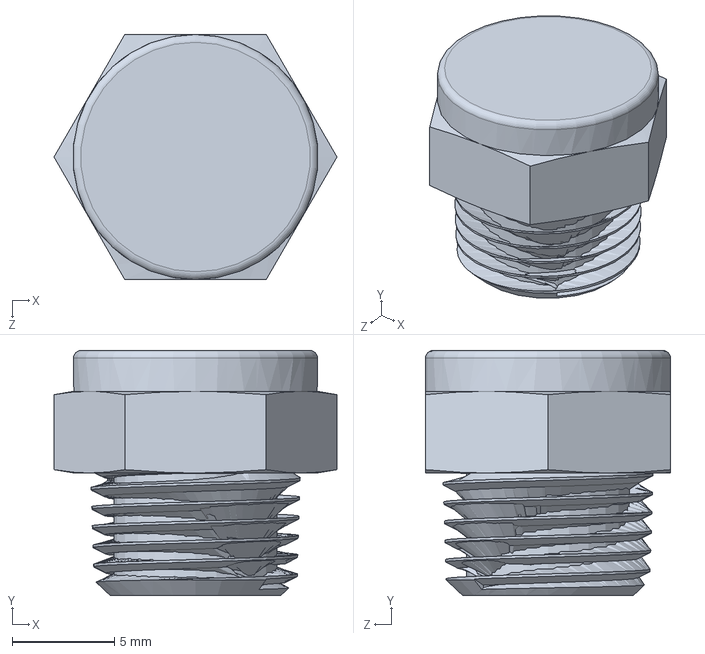
[picture p41: CAD file, 2024-04-10]
CAD/pneumatics/sbf-18n.SLDPRT
13.9 x 12.0 x 12.0 mm
