yak5150/paddle-shift/CAD/pneumatics/line-cyl-retract.SLDPRT

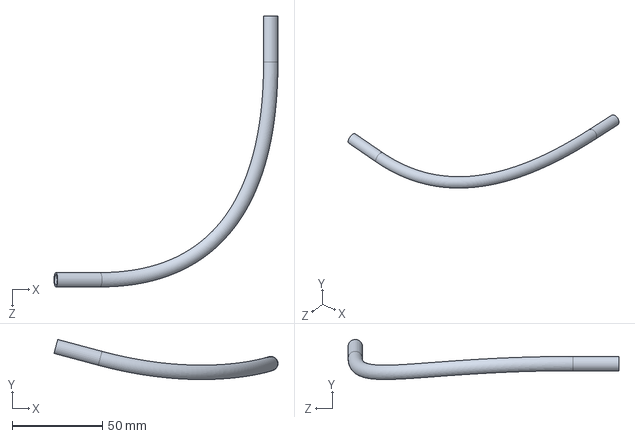
[picture p42: CAD file, 2024-04-10]
CAD/pneumatics/line-cyl-retract.SLDPRT
124.1 x 22.2 x 150.1 mm
