yak5150/paddle-shift/(list of files, cad)

Other CAD files:
CAD/actuator_mech/print 2024-02-21/switch mount (left).STL
CAD/actuator_mech/cylinder support.SLDPRT
CAD/actuator_mech/shaft support.SLDPRT
CAD/actuator_mech/switch mount.SLDPRT
CAD/47065T144_T-Slotted Framing.SLDPRT
CAD/actuator_mech/6061K31_Linear Motion Shaft.SLDPRT
CAD/actuator_mech/6338K413_Oil-Embedded Flanged Sleeve Bearing.SLDPRT
CAD/actuator_mech/7779K23_Miniature Snap-Acting Switch.SLDPRT
CAD/actuator_mech/90850A100_Grade 9 Steel Washer.SLDPRT
CAD/actuator_mech/9657K96_Compression Spring.SLDPRT
CAD/actuator_mech/97135A415_High-Strength Steel Nylon-Insert Locknut.SLDPRT
CAD/actuator_mech/a17010dp/a17010dp.SLDASM
CAD/actuator_mech/a17010dp/a17010dp_01.SLDPRT
CAD/actuator_mech/a17010dp/a17010dp_02.SLDPRT
CAD/actuator_mech/a17010dp/a17010dp_03.SLDPRT
