yak5150/paddle-shift/CAD/test_bench_assy.pdf

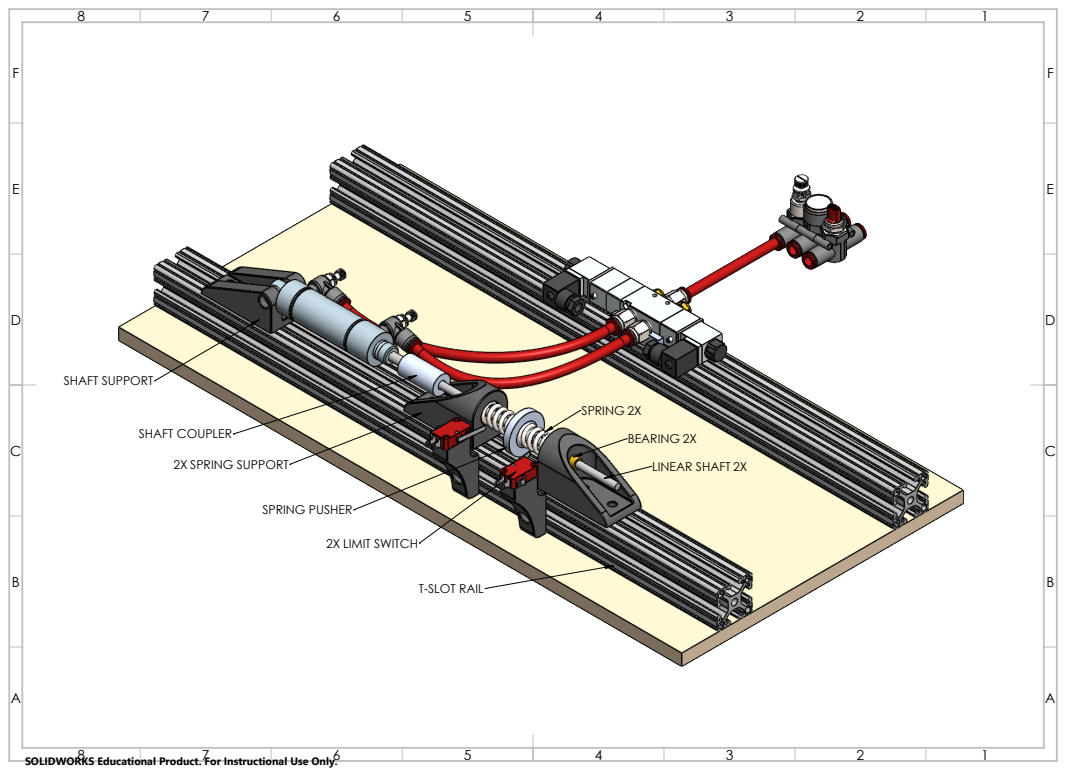
[picture p43: page 1]
SPRING PUSHER; SPRING 2X; 2X SPRING SUPPORT; LINEAR SHAFT 2X; BEARING 2X; SHAFT SUPPORT; SHAFT COUPLER; 2X LIMIT SWITCH; T-SLOT RAIL

SOLIDWORKS Educational Product. For Instructional Use Only.
