yak5150/paddle-shift/CAD/actuator_mech/Assem1.pdf

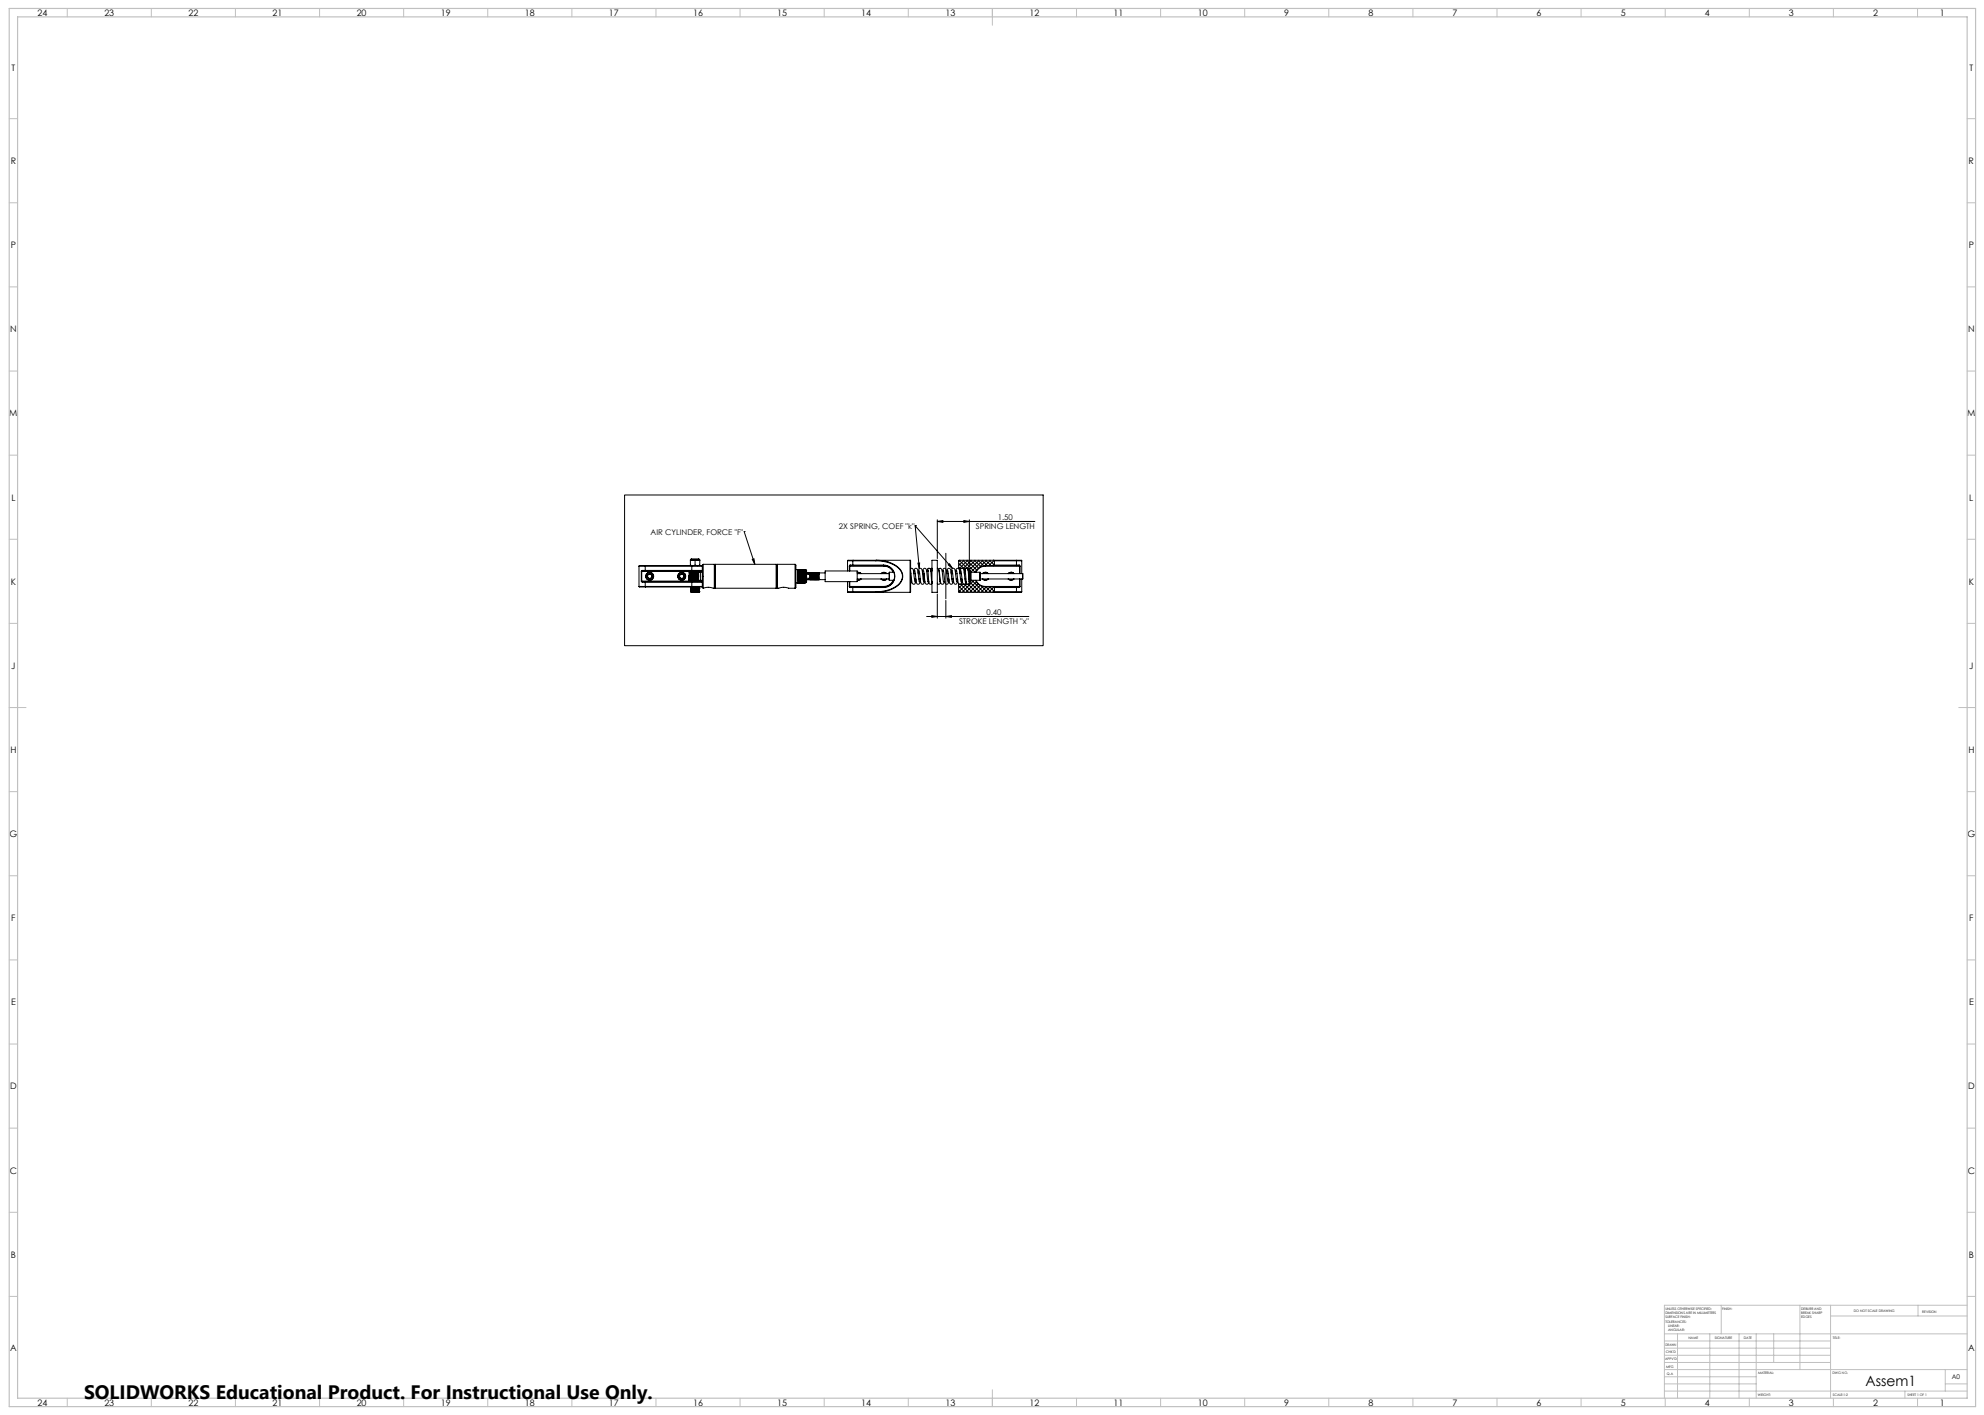
[picture p44: page 1]
SPRING LENGTH; STROKE LENGTH "x"; AIR CYLINDER, FORCE "F"; 2X SPRING, COEF "k"; FINISH:; DEBURR AND; BREAK SHARP; DO NOT SCALE DRAWING; REVISION; SCALE:1:2; SHEET 1 OF 1

UNLESS OTHERWISE SPECIFIED:
DIMENSIONS ARE IN MILLIMETERS
SURFACE FINISH:
TOLERANCES:
LINEAR:
ANGULAR:

NAME | SIGNATURE | DATE | | | | TITLE:

Assem1 SOLIDWORKS Educational Product. For Instructional Use Only.

DRAWN
CHK'D
APPV'D
MFG
Q.A | | | | MATERIAL: | DWG NO. | A0
