yak5150/paddle-shift/(commit log)

2024-04-10 adding stuff
    [47065T144_T-Slotted Framing.SLDPRT, 4V130(CEP)-06-D.SLDPRT, 6061K31_Linear Motion Shaft.SLDPRT, 6338K413_Oil-Embedded Flanged Sleeve Bearing.SLDPRT, 7779K23_Miniature Snap-Acting Switch.SLDPRT, 90850A100_Grade 9 Steel Washer.SLDPRT, 9657K96_Compression Spring.SLDPRT, 97135A415_High-Strength Steel Nylon-Insert Locknut.SLDPRT]
2024-04-11 added shiftCount.py
    [fsae_michigan18_&_madformulateam_mft02_evo_&_Yak_5150_&_stint_3.csv]
2024-04-11 shiftCount converting to arduino format
    [fsae_michigan18_&_madformulateam_mft02_evo_&_Yak_5150_&_stint_3.csv]
2024-04-12 shiftCount works! spits out data in Justins arduino format
